Picatout/pixdel4/README.md

pixdel
======

RGB LED contrôlé par pic10F200 par interface rs-232 TTL

exemple de céduleur temps réel. 

voir blog: http://picatout-jd.blogspot.ca/2013/03/pixdel-plus-complexe-quil-ny-parait.html
