Picatout/pixdel4/pixdel4.X/schéma des transitions.png

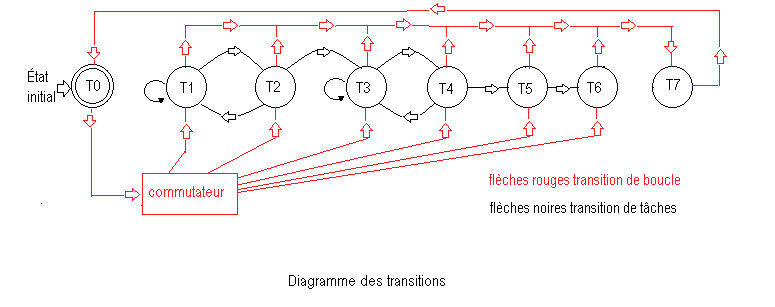
pixdel4.X/schéma des transitions.png
