Picatout/pixdel4/pixdel4.X/schéma-pixdel.png

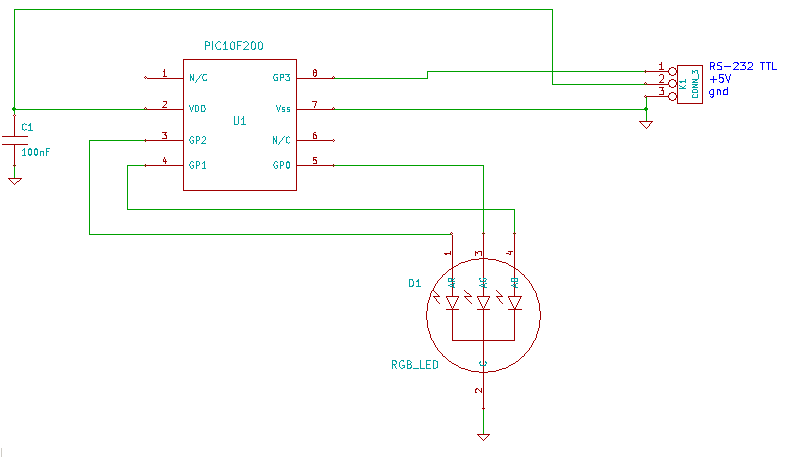
pixdel4.X/schéma-pixdel.png
