Picatout/pixdel4/pixdel.pdf

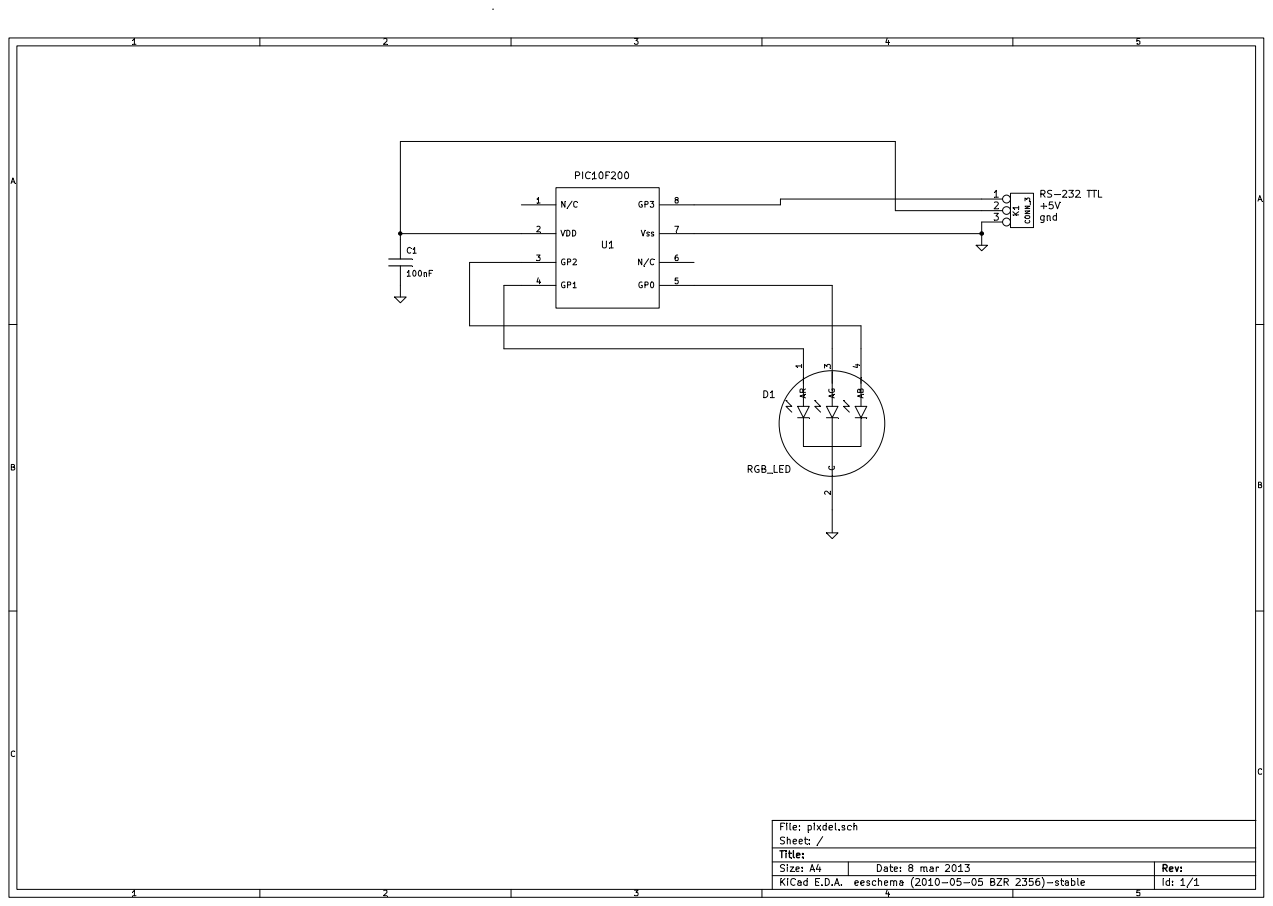
[picture p3: page 1]
