Picatout/pixdel4/pixdel.sch

## KiCad design pixdel.sch (2013-03-30)

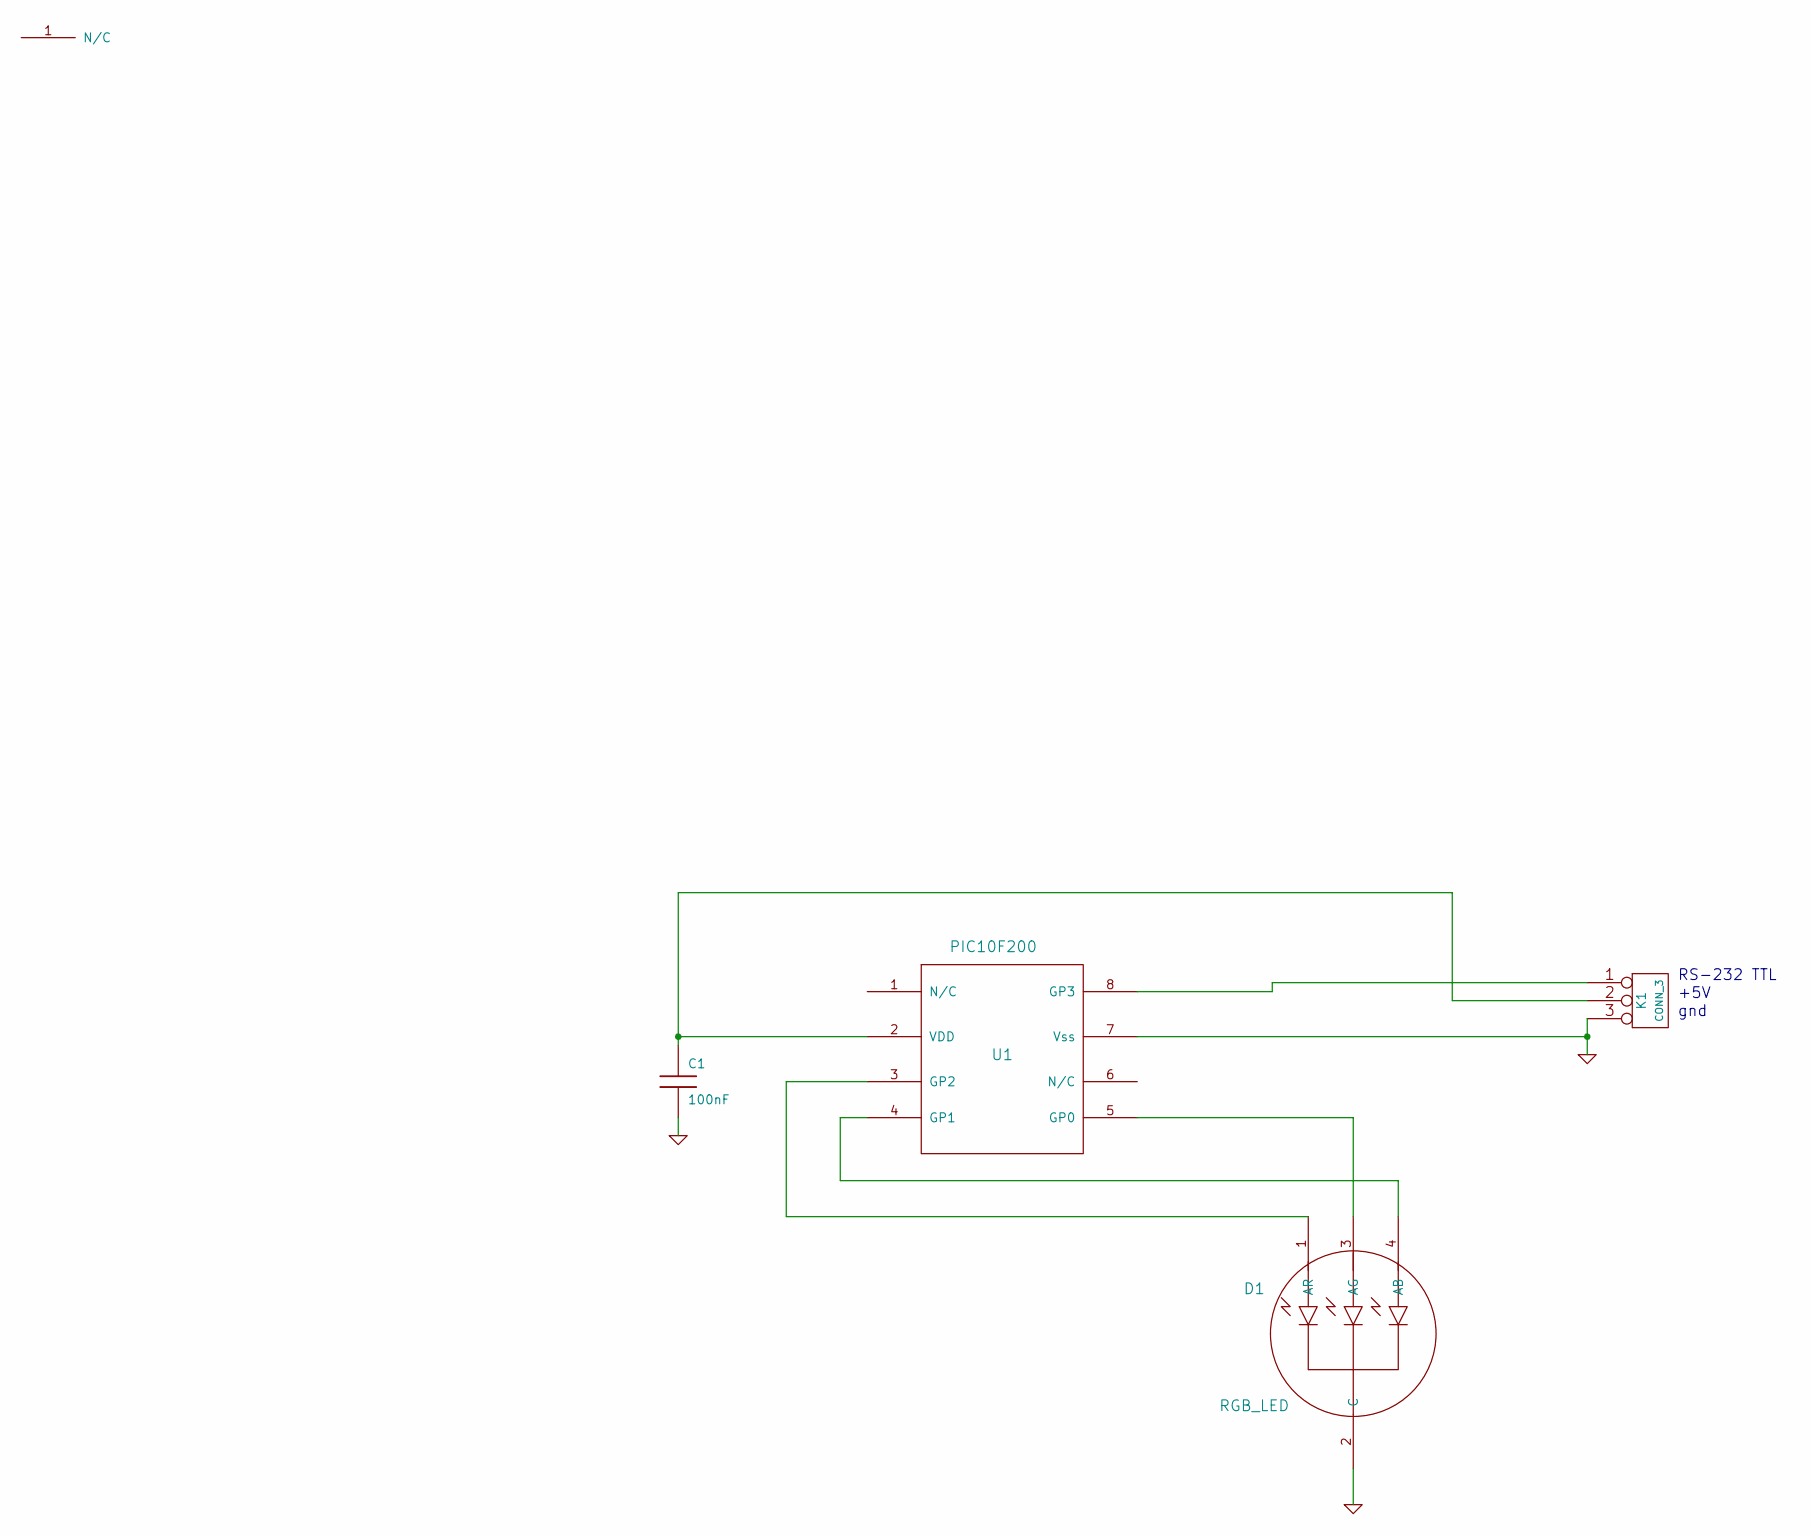
[picture p4: schematic pixdel.sch]

Parts:
C1: 100nF
D1: RGB_LED
K1: CONN_3
U1: PIC10F200

Connections:
GND: C1.2, D1.2 (C), K1.3, U1.7 (Vss)
unnamed: C1.1, K1.2 (PM), U1.2 (VDD)
unnamed: D1.1 (AR), U1.3 (GP2)
unnamed: D1.3 (AG), U1.5 (GP0)
unnamed: D1.4 (AB), U1.4 (GP1)
unnamed: K1.1, U1.8 (GP3)

Notes on the sheet:
gnd
+5V
RS-232 TTL
