Picatout/pixdel4/(commit log)

2013-03-24 version 4 du firmware pixdel
    [pixdel.sch]
2013-03-29 mise à jour schéma, et nettoyage fichier .asm
    [pixdel.sch]
2013-03-30 overclocking Fosc à 4,619Mhz pour augmenter la vitesse des commandes à 14400 BAUD
    [pixdel.sch]
